openSX70/Documentation/specifications/DC-motor/pictures/SX70_Motor_Griega_3.jpg

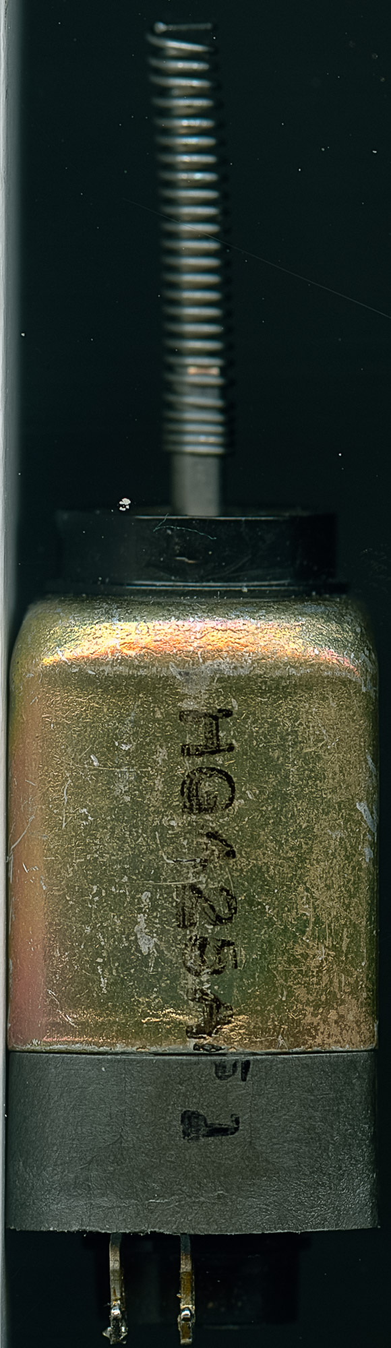
specifications/DC-motor/pictures/SX70_Motor_Griega_3.jpg
