openSX70/Documentation/specifications/DC-motor/pictures/SX70_Motor_Griega_2.jpg

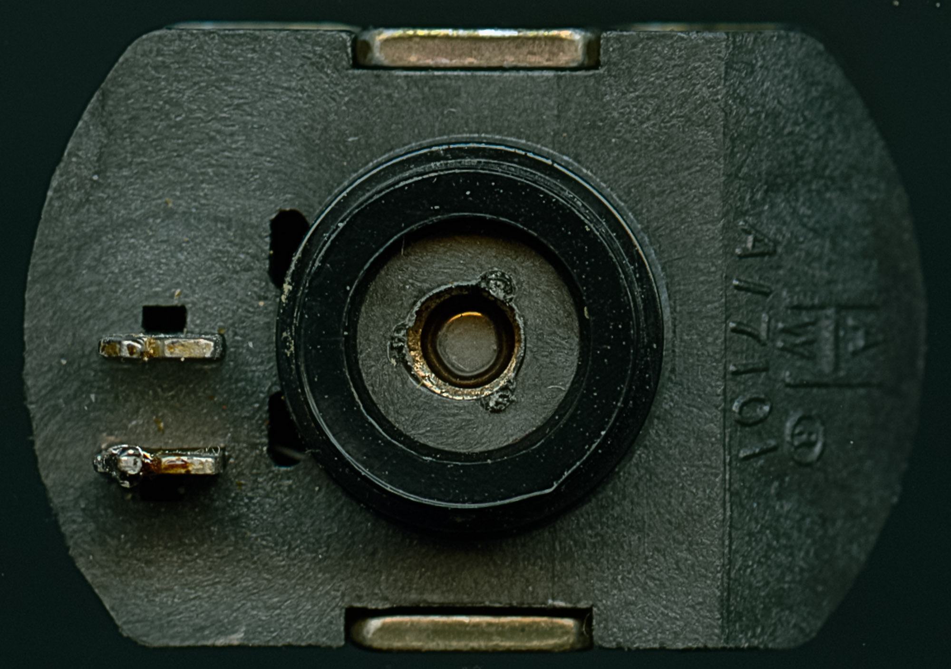
specifications/DC-motor/pictures/SX70_Motor_Griega_2.jpg
