openSX70/Documentation/README.md

# tutorials
All sort of documents and tutorials about the SX70
All sort of documents related to SX70
