openSX70/Documentation/specifications/Basics/SX70-Cable-Routing-GRAND-SCHEME.pdf

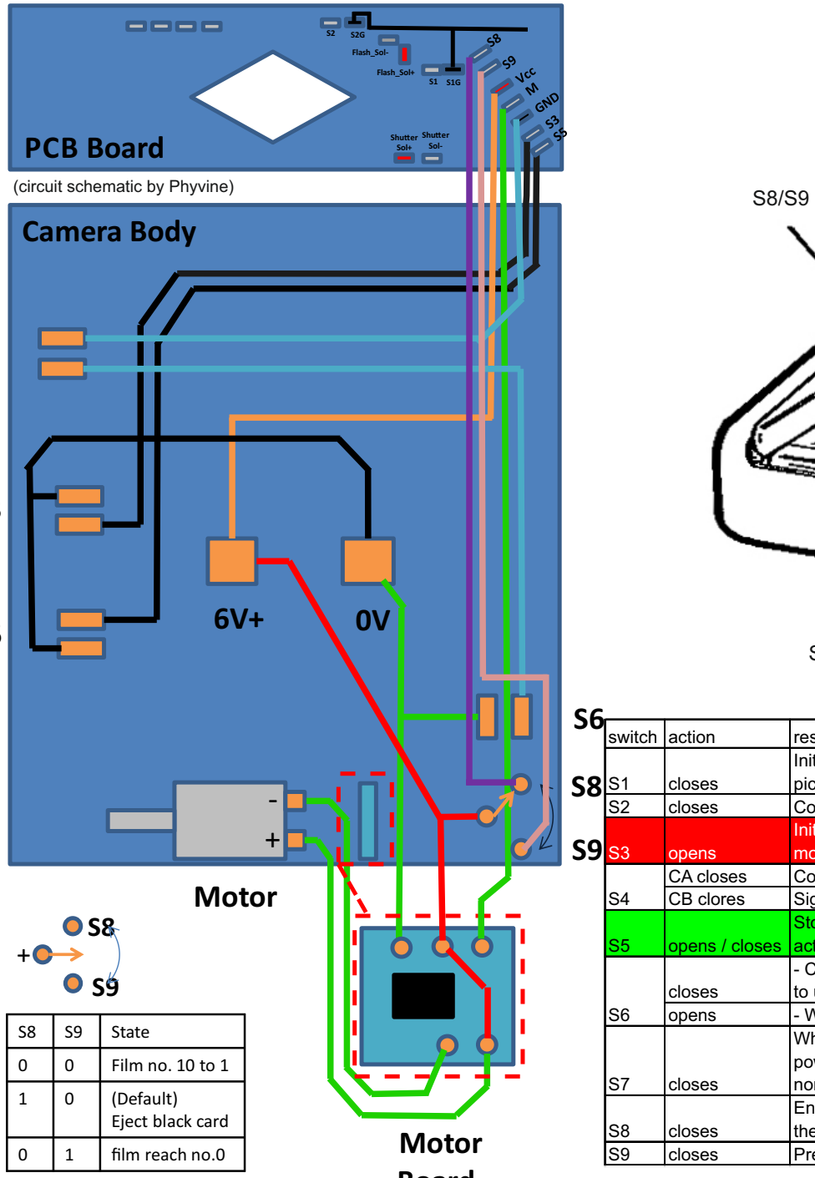
[picture p3: figure]
State; Film no. 10 to 1; (Default) Eject black card; film reach no.0; Motor; PCB Board; Camera Body; Flash_Sol+; Flash_Sol-; Shuer Sol+; Shuer Sol-; (circuit schematic by Phyvine)

S5

S3

# Board

S7

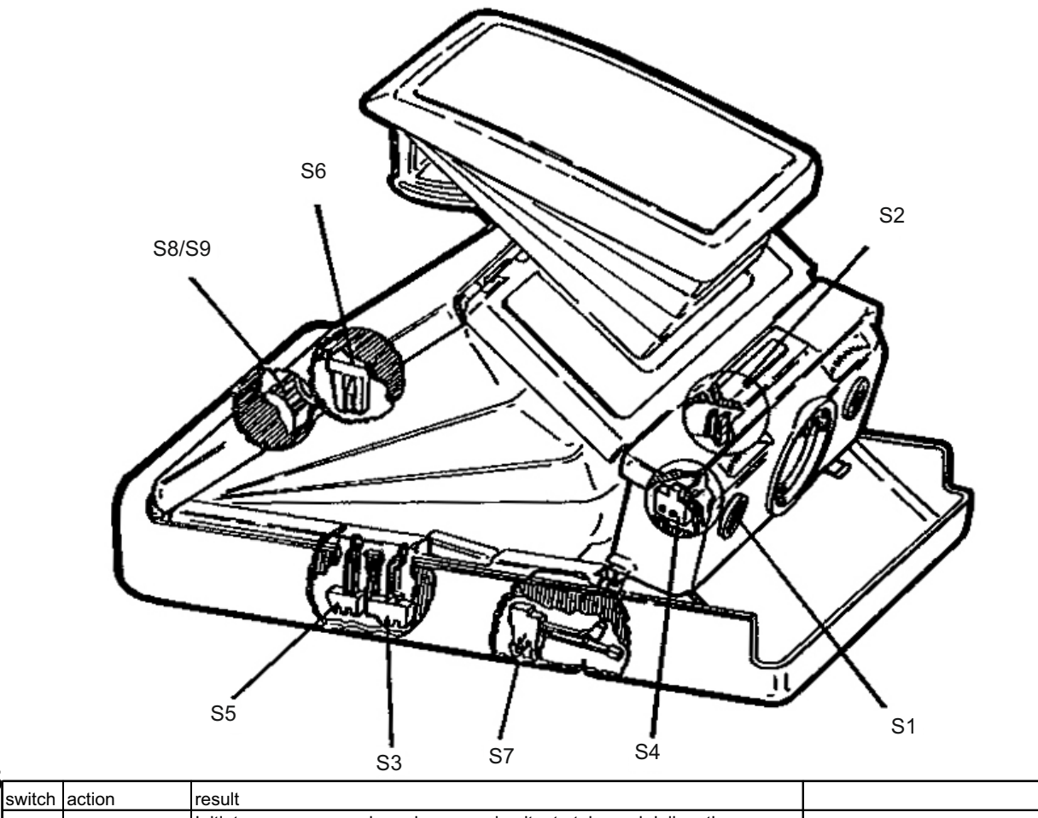
[picture p4: figure]
switch; action; result

S1 | closes | Initiates exposure cycle and causes circuitry to take and deliver the pictures. | Shutter button, taking a picture
S2 | closes | Connects circuitry to take flash pictures. | Flash mode detected
S3 | opens | Initiates «Y», 40 milliseconds delay. (Power down solenoid #2 in the flash mode)
S4 | CA closes | Controls power to solenoid #1 (drop current to holding level)
| CB clores | Signals the ECM to start the motor.
S5 | opens / closes | Stops motor both by closing and opening depeending uponsequence of action and internal circuitry.
S6 | closes | - Connects the battery to the electronic circuitry when thecamera is open to use. | Camera closed-OFF
| opens | - When the camera closed, cuts power from battery. | Camera open-ON
S7 | closes | When S8 is also closed, it provides power to the camera when the front power is latched (for dark slide eject). Also acts as an interlock during normal picture taking.
S8 | closes | Enables (with S7 closed) the circuitry to eject dark slide.Opens again after the dark slide is ejected. | counter-related
S9 | closes | Prevents firing flash if film pack counter is on «0». | counter-related
