openSX70/Documentation/specifications/shutter/SX70_aperture.pdf

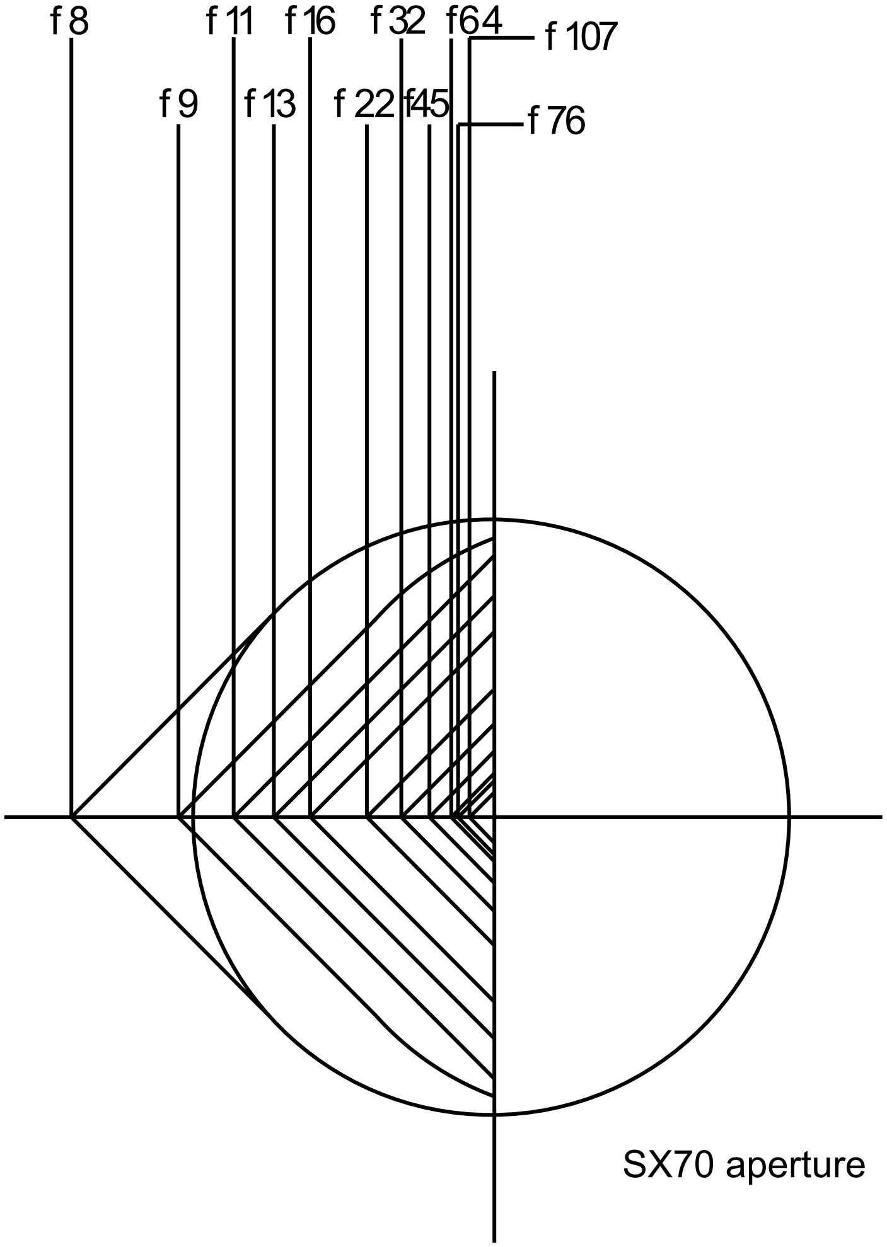
[picture p5: figure]
SX70 aperture
