openSX70/Documentation/lens&bellows-openSX70.png

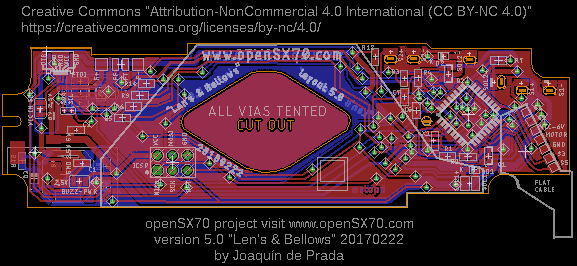
lens&bellows-openSX70.png
