openSX70/Documentation/specifications/DC-motor/FK-1505A-1.jpg

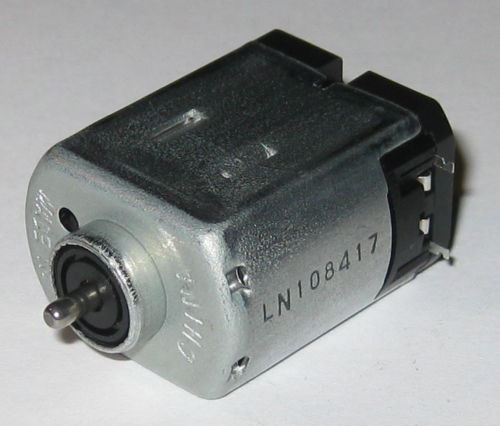
specifications/DC-motor/FK-1505A-1.jpg
