openSX70/Documentation/specifications/flexcable/flexcable-grid-scan.jpg

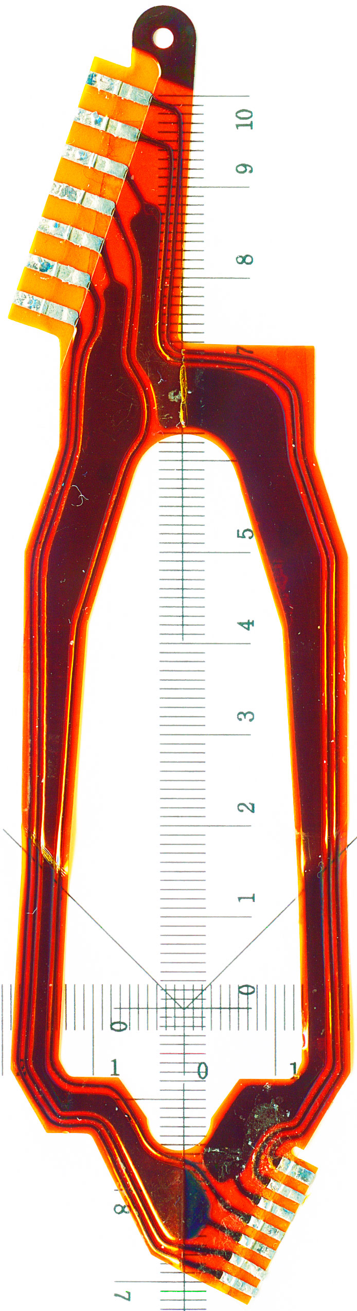
specifications/flexcable/flexcable-grid-scan.jpg
