openSX70/Documentation/specifications/outline/Sonar-LED.jpg

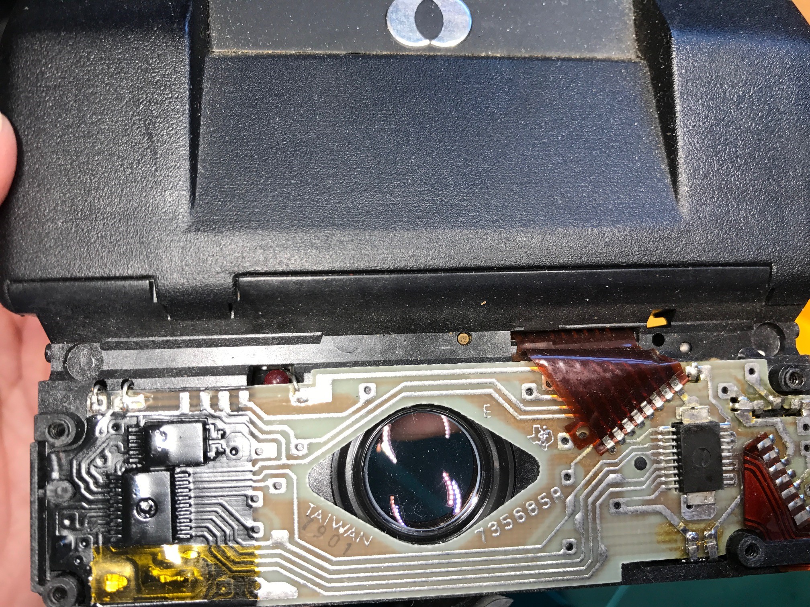
specifications/outline/Sonar-LED.jpg
