openSX70/Documentation/specifications/powerdrop/cablecortoalpha2.png

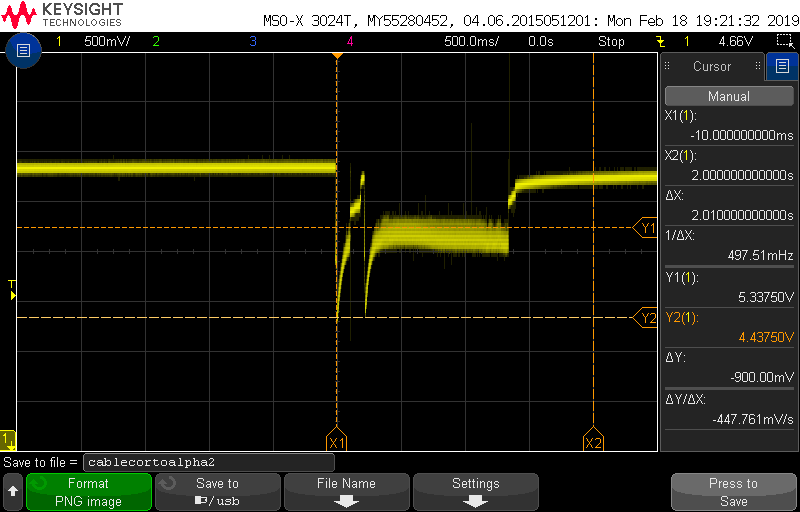
specifications/powerdrop/cablecortoalpha2.png
