openSX70/Documentation/specifications/powerdrop/cablecortoalpha4.png

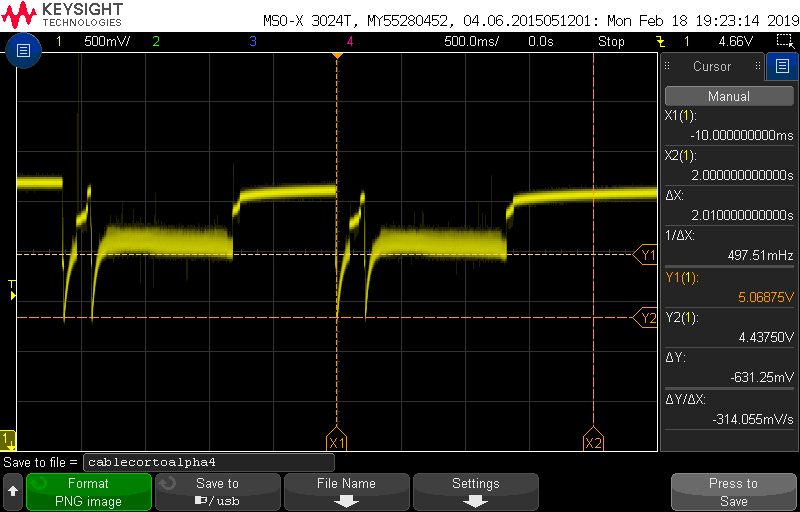
specifications/powerdrop/cablecortoalpha4.png
