openSX70/Documentation/specifications/powerdrop/cablecortoalpha.png

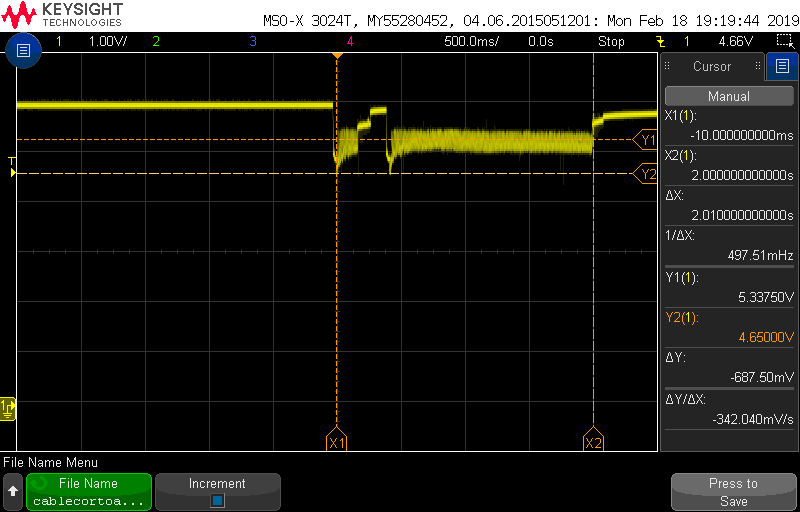
specifications/powerdrop/cablecortoalpha.png
