openSX70/Documentation/specifications/powerdrop/cablecortomodel2 1.bmp

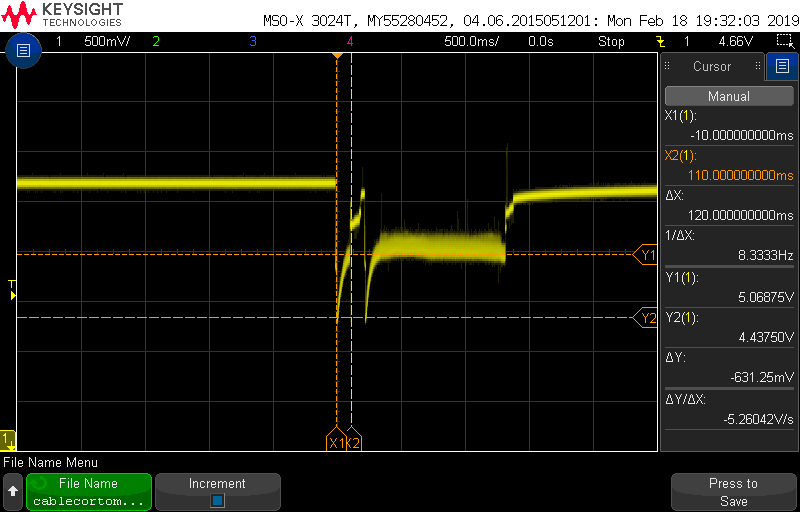
specifications/powerdrop/cablecortomodel2 1.bmp
