openSX70/Documentation/specifications/powerdrop/cablecortomodel2 2.bmp

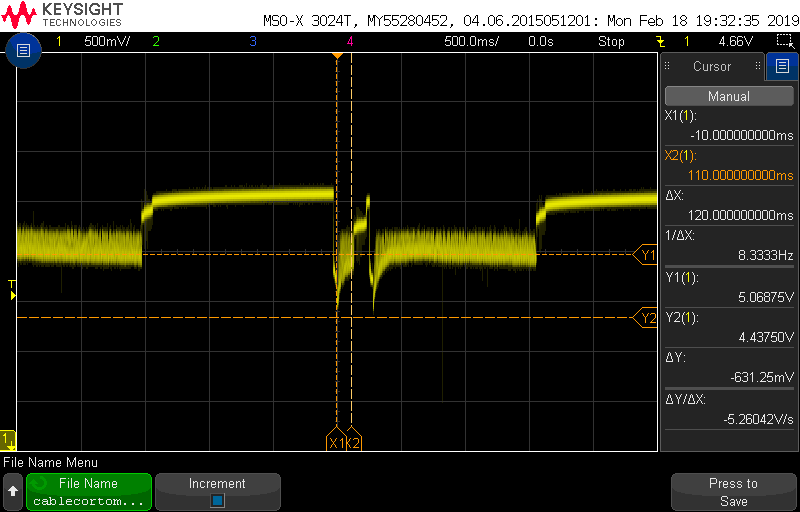
specifications/powerdrop/cablecortomodel2 2.bmp
