openSX70/Documentation/specifications/powerdrop/model2.png

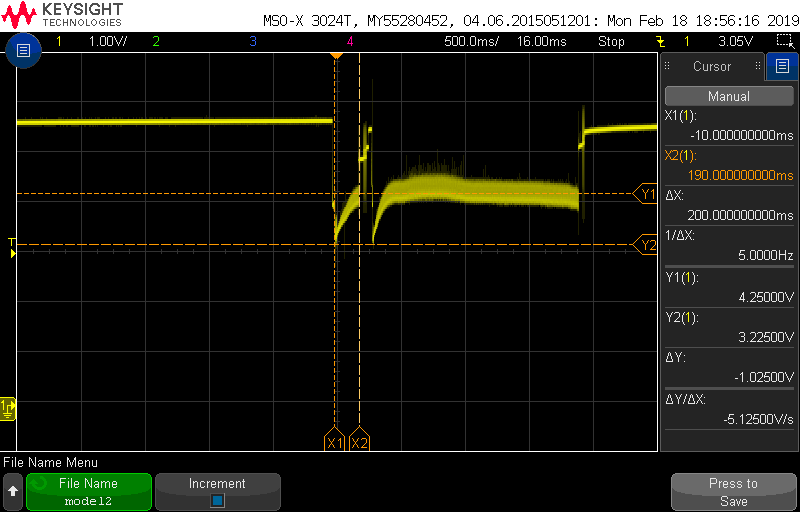
specifications/powerdrop/model2.png
