openSX70/Documentation/specifications/shutter/20181019_SX70_shutter-blades-1HC.jpg

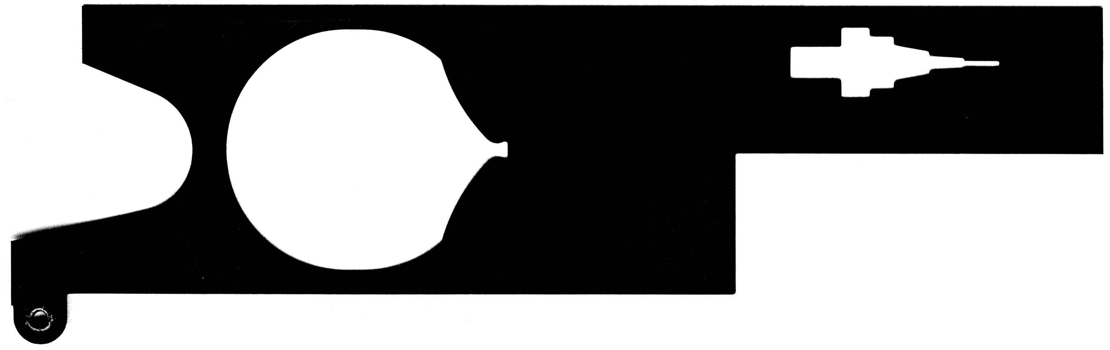
specifications/shutter/20181019_SX70_shutter-blades-1HC.jpg
