openSX70/Documentation/specifications/sonar/2018-12-30-beta-program-12.jpg

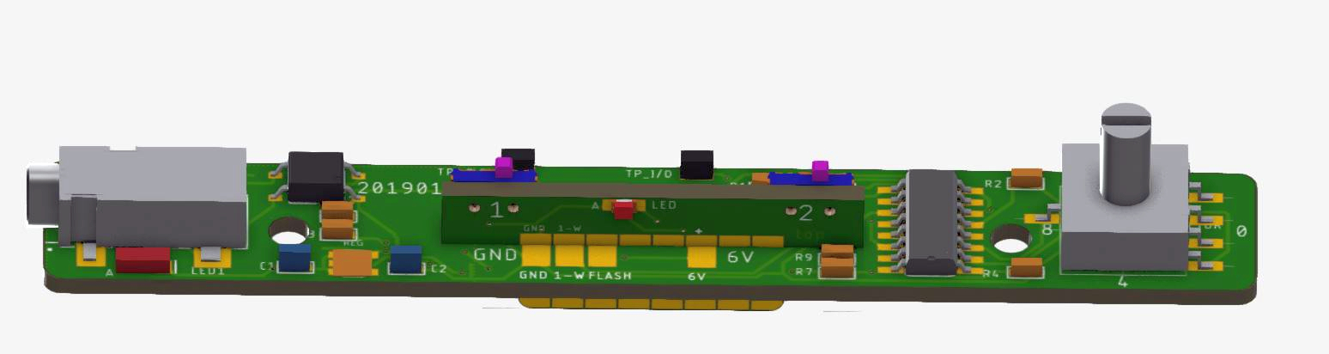
specifications/sonar/2018-12-30-beta-program-12.jpg
