openSX70/Documentation/specifications/sonar/orange-focus-WA000004.BMP

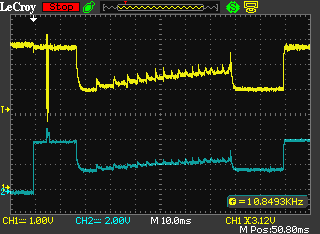
specifications/sonar/orange-focus-WA000004.BMP
