openSX70/Documentation/specifications/sonar/orange-focus-WA000007.BMP

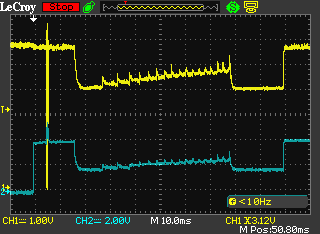
specifications/sonar/orange-focus-WA000007.BMP
