openSX70/Documentation/specifications/sonar/orange-park-WA000010.BMP

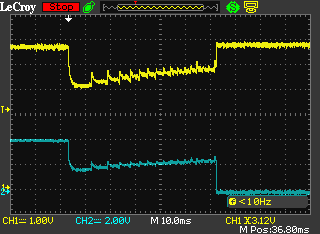
specifications/sonar/orange-park-WA000010.BMP
