openSX70/Documentation/specifications/sonar/PCB_outline-SonarV3_SIMPLE_UPDATE_Colors.jpg

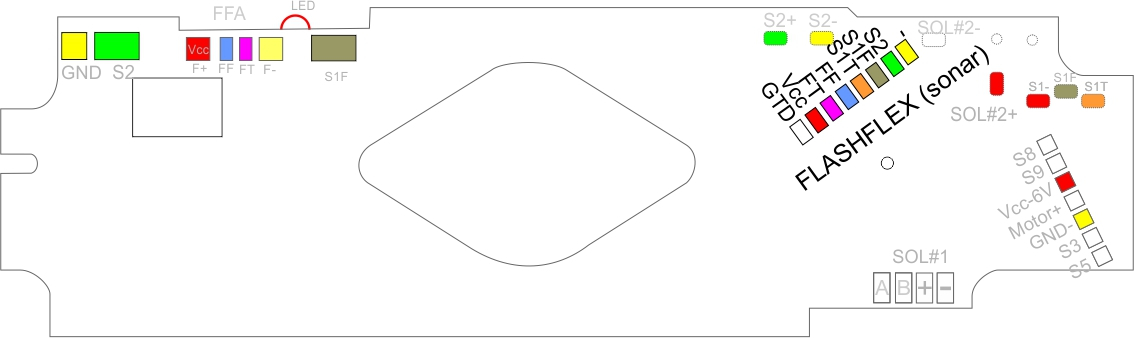
specifications/sonar/PCB_outline-SonarV3_SIMPLE_UPDATE_Colors.jpg
