openSX70/Documentation/specifications/sonar/WA000001.BMP

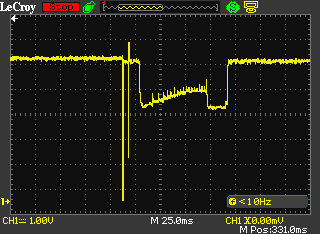
specifications/sonar/WA000001.BMP
