openSX70/Documentation/specifications/sonar/WA000003.BMP

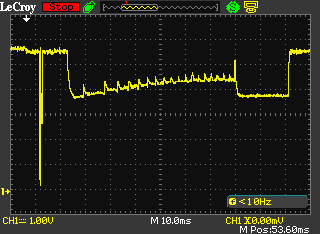
specifications/sonar/WA000003.BMP
