openSX70/Documentation/specifications/sonar/WA000004.BMP

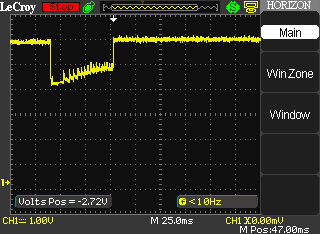
specifications/sonar/WA000004.BMP
