openSX70/Documentation/specifications/sonar/WA000005.BMP

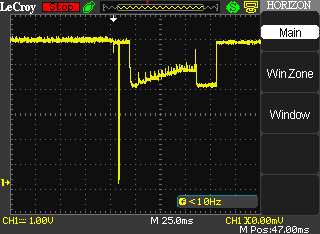
specifications/sonar/WA000005.BMP
