openSX70/Documentation/specifications/sonar/WA000006.BMP

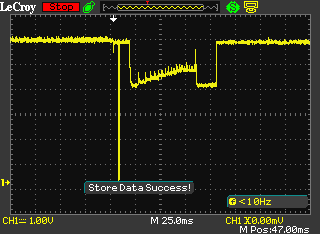
specifications/sonar/WA000006.BMP
