openSX70/Documentation/specifications/sonar/WA000007.BMP

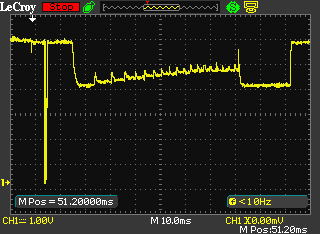
specifications/sonar/WA000007.BMP
