openSX70/Documentation/specifications/sonar/WA000008.BMP

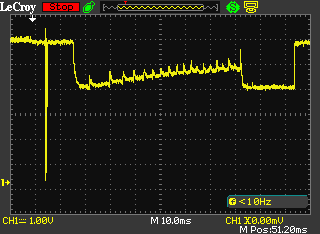
specifications/sonar/WA000008.BMP
