openSX70/Documentation/specifications/sonar/WA000009.BMP

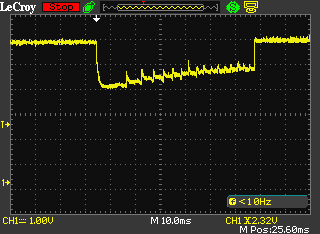
specifications/sonar/WA000009.BMP
