openSX70/Documentation/specifications/sonar/WA000010.BMP

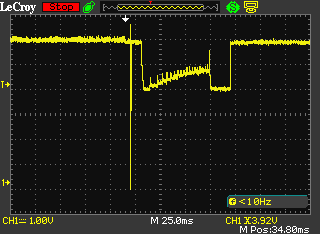
specifications/sonar/WA000010.BMP
