openSX70/Documentation/specifications/sonar/WA000011.BMP

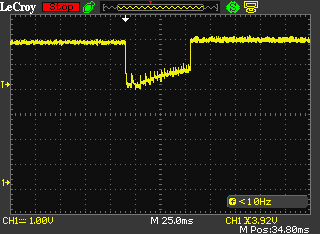
specifications/sonar/WA000011.BMP
