openSX70/Documentation/specifications/sonar/WA000012.BMP

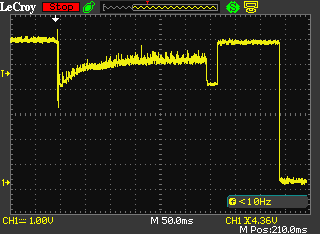
specifications/sonar/WA000012.BMP
