openSX70/Documentation/specifications/sonar/WA000013.BMP

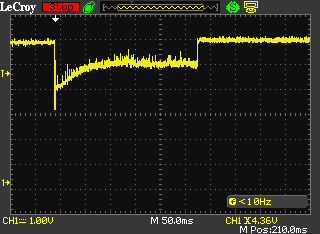
specifications/sonar/WA000013.BMP
