openSX70/Documentation/specifications/sonar/WA000014.BMP

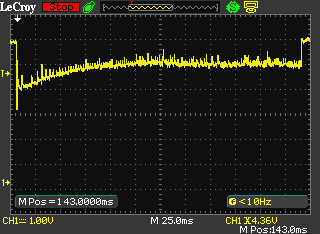
specifications/sonar/WA000014.BMP
