openSX70/Documentation/specifications/sonar/WA000015.BMP

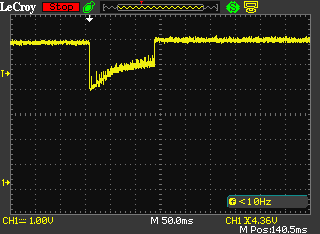
specifications/sonar/WA000015.BMP
