openSX70/Documentation/specifications/sonar/white-focus-WA000002.BMP

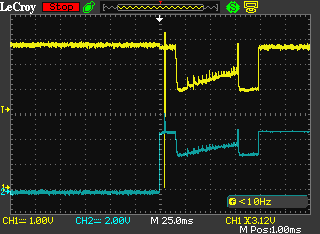
specifications/sonar/white-focus-WA000002.BMP
