openSX70/Documentation/specifications/sonar/white-focus-WA000005.BMP

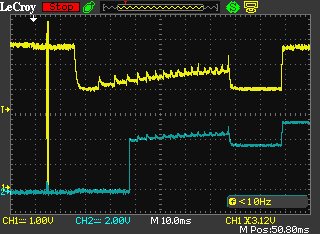
specifications/sonar/white-focus-WA000005.BMP
