openSX70/Documentation/specifications/sonar/white-park-WA000008.BMP

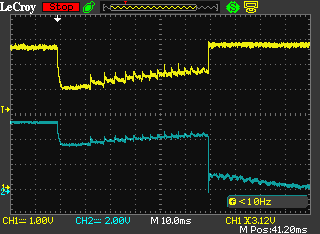
specifications/sonar/white-park-WA000008.BMP
