openSX70/Documentation/specifications/sonar/yellow-focus-WA000003.BMP

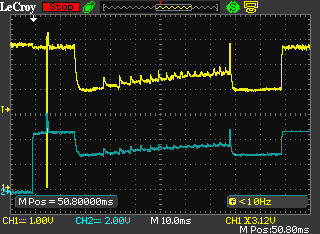
specifications/sonar/yellow-focus-WA000003.BMP
