openSX70/Documentation/specifications/sonar/yellow-focus-WA000006.BMP

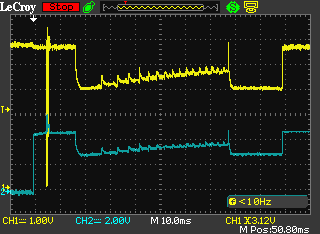
specifications/sonar/yellow-focus-WA000006.BMP
