openSX70/Documentation/specifications/sonar/yellow-park-WA000009.BMP

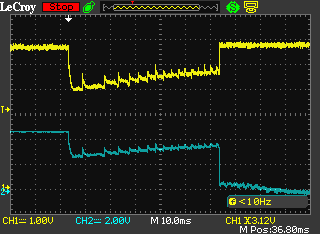
specifications/sonar/yellow-park-WA000009.BMP
