openSX70/Documentation/specifications/flexcable/flex-cable-proper.dxf

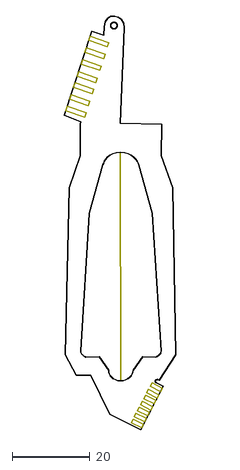
[picture p46: CAD file, 2019-02-09]
specifications/flexcable/flex-cable-proper.dxf
28.8 x 106.8
