openSX70/Documentation/specifications/outline/PCB_outline-SonarV3_NEW_HOLE.dxf

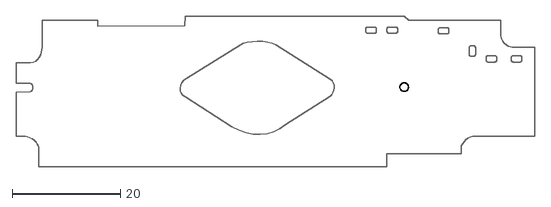
[picture p47: CAD file, 2018-10-12]
specifications/outline/PCB_outline-SonarV3_NEW_HOLE.dxf
95.9 x 27.9
