openSX70/Documentation/specifications/paperPCB/SX-70_Paper_PCB_Model3_BIG2.dxf

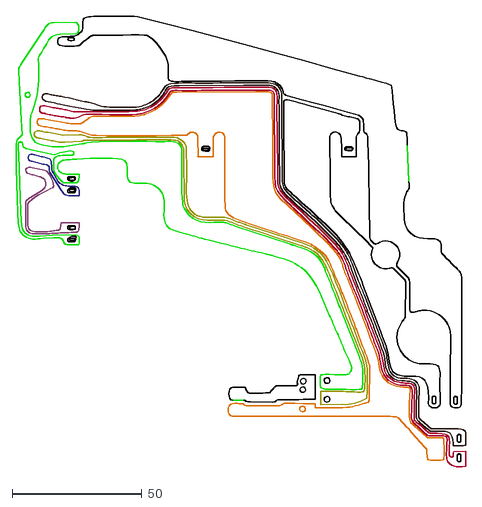
[picture p48: CAD file, 2019-02-09]
specifications/paperPCB/SX-70_Paper_PCB_Model3_BIG2.dxf
173.1 x 173.4
