openSX70/Documentation/specifications/shutter/blade-1.dxf

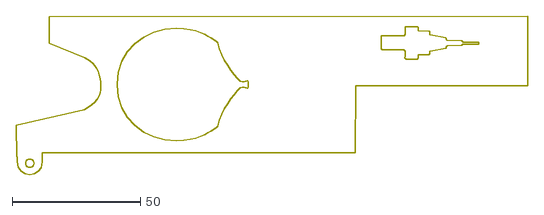
[picture p49: CAD file, 2018-10-22]
specifications/shutter/blade-1.dxf
199.7 x 61.8
