openSX70/Documentation/specifications/flexcable/FLEXCABLE2.dxf

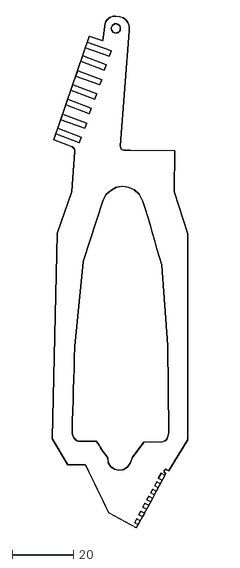
[picture p50: CAD file, 2019-02-09]
specifications/flexcable/FLEXCABLE2.dxf
44.3 x 167.8
