openSX70/Documentation/specifications/outline/PCB_outline-SonarV3_bDOCU_.dxf

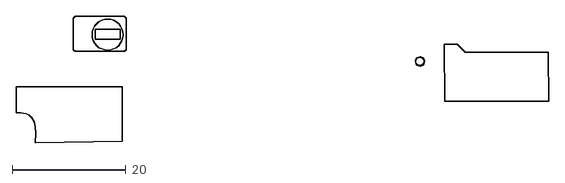
[picture p51: CAD file, 2018-10-12]
specifications/outline/PCB_outline-SonarV3_bDOCU_.dxf
93.6 x 22.2
