openSX70/Documentation/specifications/paperPCB/SX-70_Paper_PCB_Model3_BIG-new.dxf

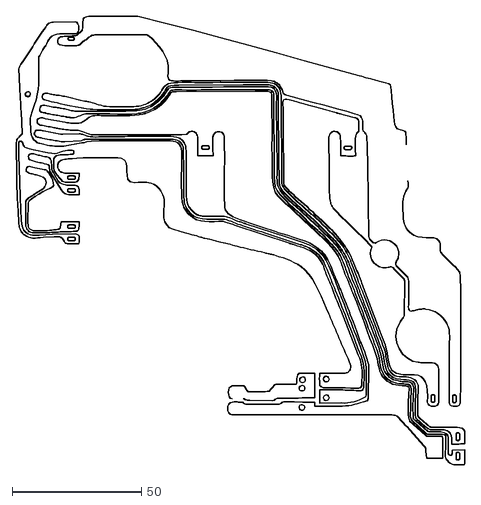
[picture p52: CAD file, 2019-02-09]
specifications/paperPCB/SX-70_Paper_PCB_Model3_BIG-new.dxf
173.1 x 173.4
