openSX70/Documentation/specifications/shutter/blade-2.dxf

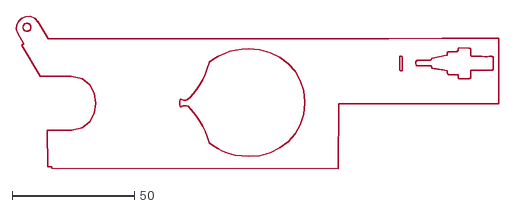
[picture p53: CAD file, 2018-10-22]
specifications/shutter/blade-2.dxf
197.6 x 62.3
