openSX70/Documentation/specifications/outline/PCB_outline-SonarV3_SIMPLE_HOLES2.dxf

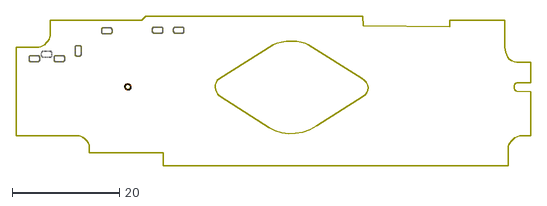
[picture p54: CAD file, 2018-10-12]
specifications/outline/PCB_outline-SonarV3_SIMPLE_HOLES2.dxf
95.9 x 27.9
