openSX70/Documentation/specifications/paperPCB/SX-70_Paper_PCB_Model3_BIG.dxf

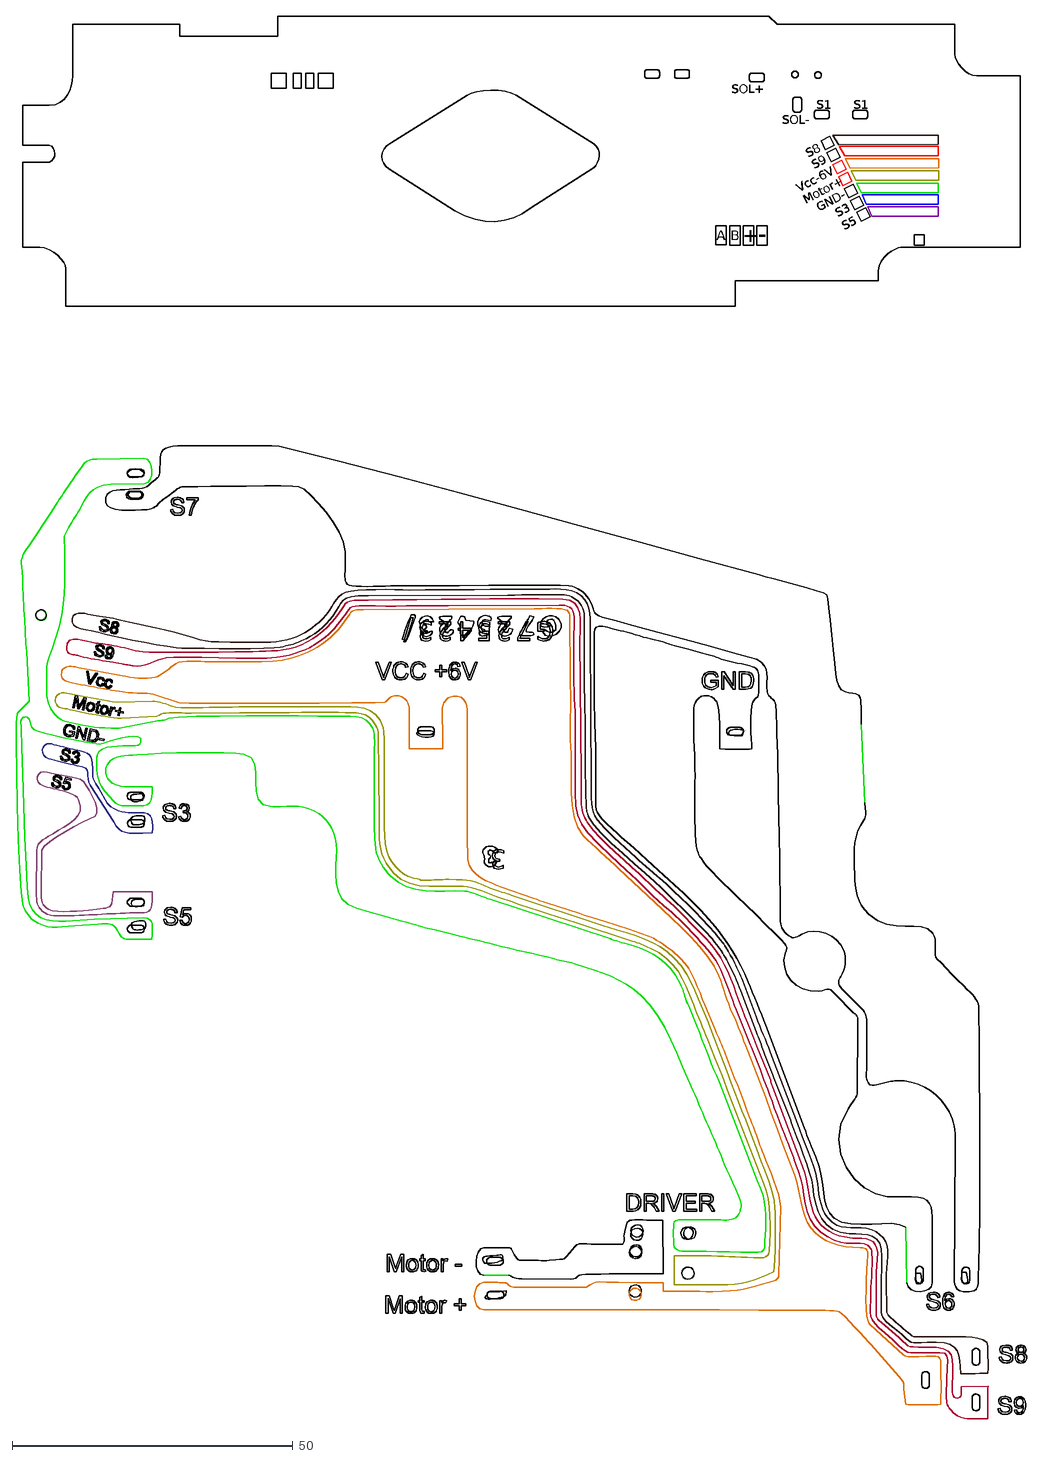
[picture p55: CAD file, 2019-02-09]
specifications/paperPCB/SX-70_Paper_PCB_Model3_BIG.dxf
S1
SOL+
SOL-
A
B
+
-
S8
S3
S9
Vcc-6V
Motor+
GND-
S5
