openSX70/Documentation/specifications/outline/PCB_outline-SonarV3_SIMPLE_dimensions.dxf

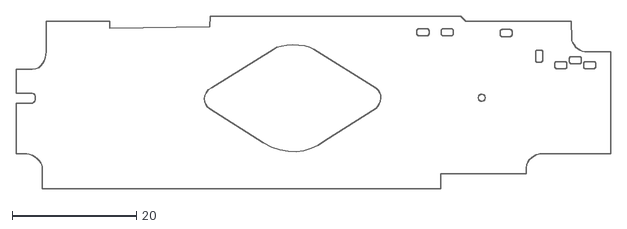
[picture p56: CAD file, 2018-10-12]
specifications/outline/PCB_outline-SonarV3_SIMPLE_dimensions.dxf
95.9 x 27.9
