openSX70/Documentation/specifications/outline/PCB_outline-SonarV2_tDOCU.dxf

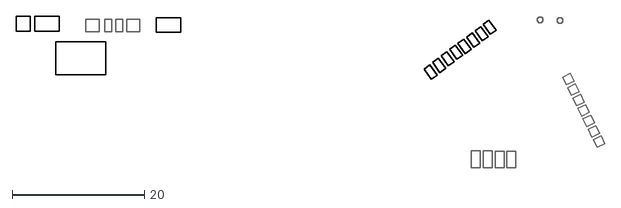
[picture p57: CAD file, 2018-10-12]
specifications/outline/PCB_outline-SonarV2_tDOCU.dxf
89.0 x 22.9
