openSX70/Documentation/specifications/outline/PCB_outline-SonarV3_SIMPLE_UPDATE_Colors_MIRRROR.dxf

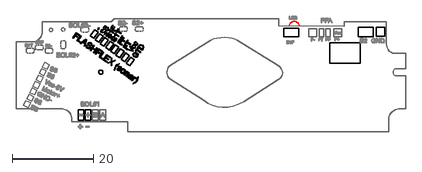
[picture p58: CAD file, 2018-10-12]
specifications/outline/PCB_outline-SonarV3_SIMPLE_UPDATE_Colors_MIRRROR.dxf
95.9 x 28.4
