openSX70/Documentation/specifications/outline/PCB_outline-SonarV3_SIMPLE_texts.dxf

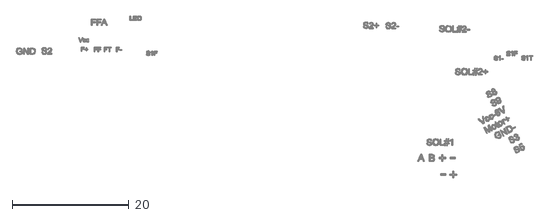
[picture p59: CAD file, 2018-10-12]
specifications/outline/PCB_outline-SonarV3_SIMPLE_texts.dxf
88.5 x 27.8
