openSX70/Documentation/specifications/outline/PCB_outline-SonarV3_SIMPLE_HOLES.dxf

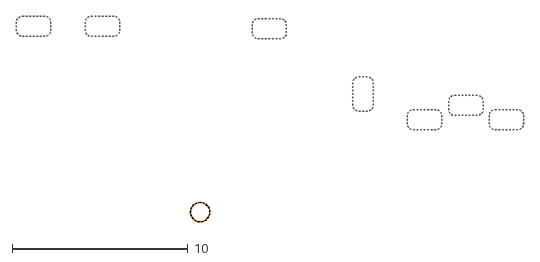
[picture p60: CAD file, 2018-10-12]
specifications/outline/PCB_outline-SonarV3_SIMPLE_HOLES.dxf
28.8 x 11.7
