openSX70/Documentation/specifications/sonar/sonar-wiring.pdf

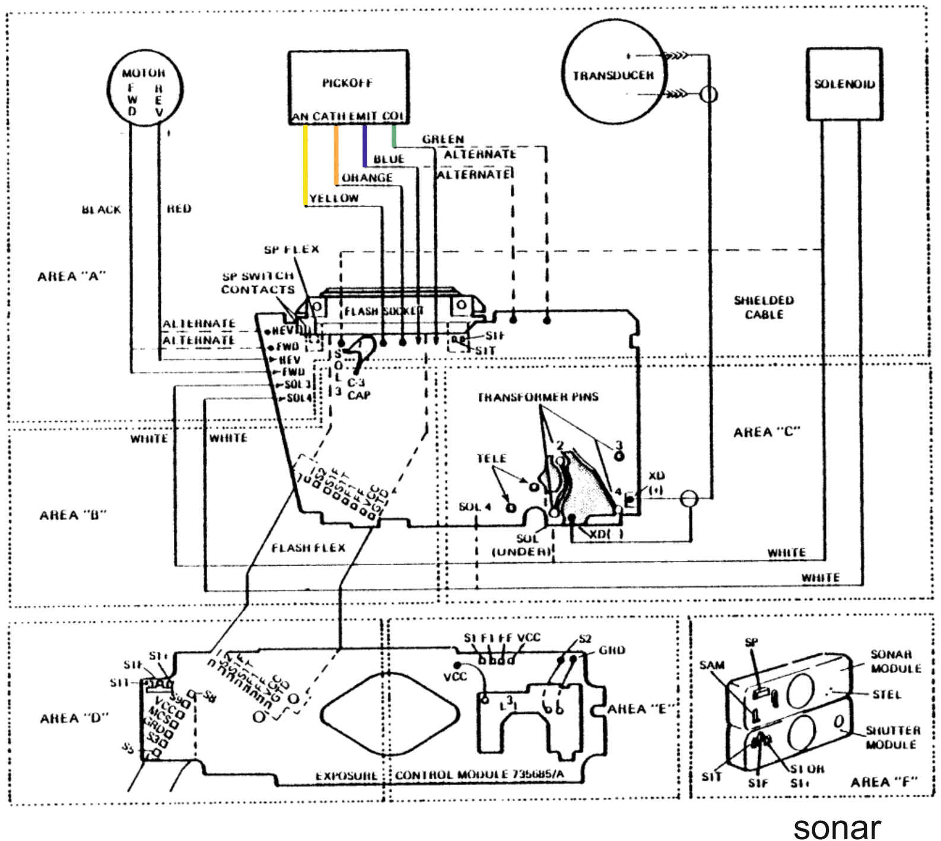
[picture p61: page 1]

sonar
