openSX70/Documentation/specifications/sonar/sonar-wiring-repair-manual.pdf

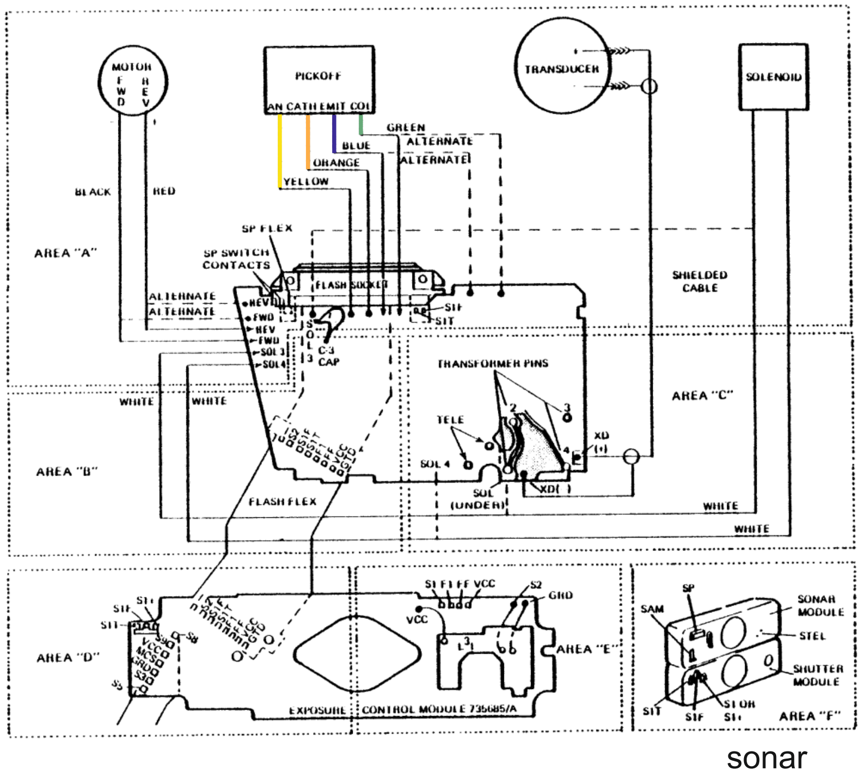
[picture p62: page 1]

sonar
