openSX70/Documentation/specifications/Basics/PCB-SONAR-legend-colours.pdf

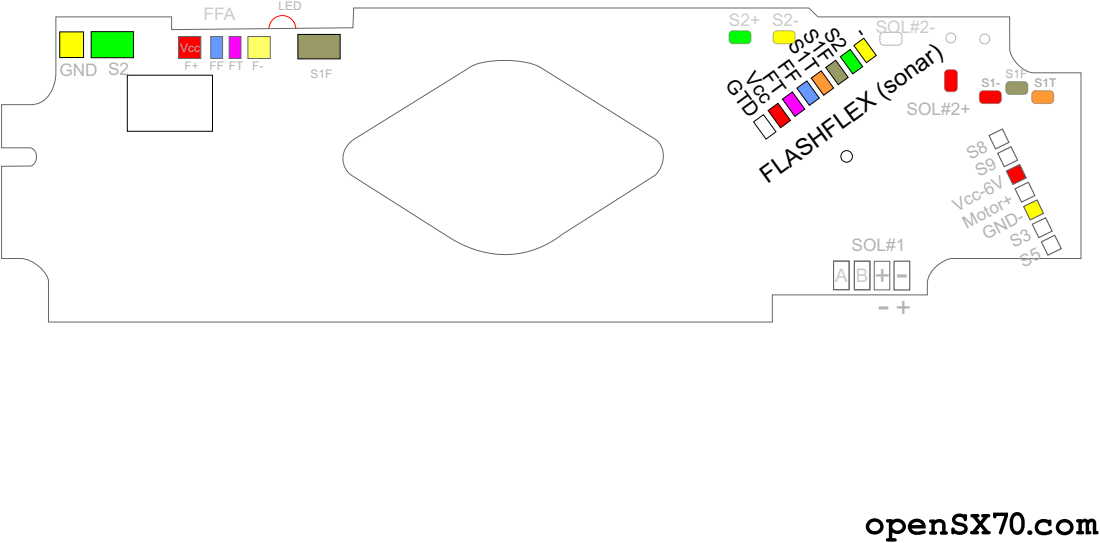
[picture p114: page 1]
SOL#2-; SOL#2+; SOL#1; FFA; GND S2; Vcc; LED

FLASHFLEX (sonar) GTD Vcc FTFF S1T S1FS2-

S9 Vcc-6V Motor+ GND- S5
