openSX70/Documentation/specifications/Basics/PCB_outlines-dimmensions.pdf

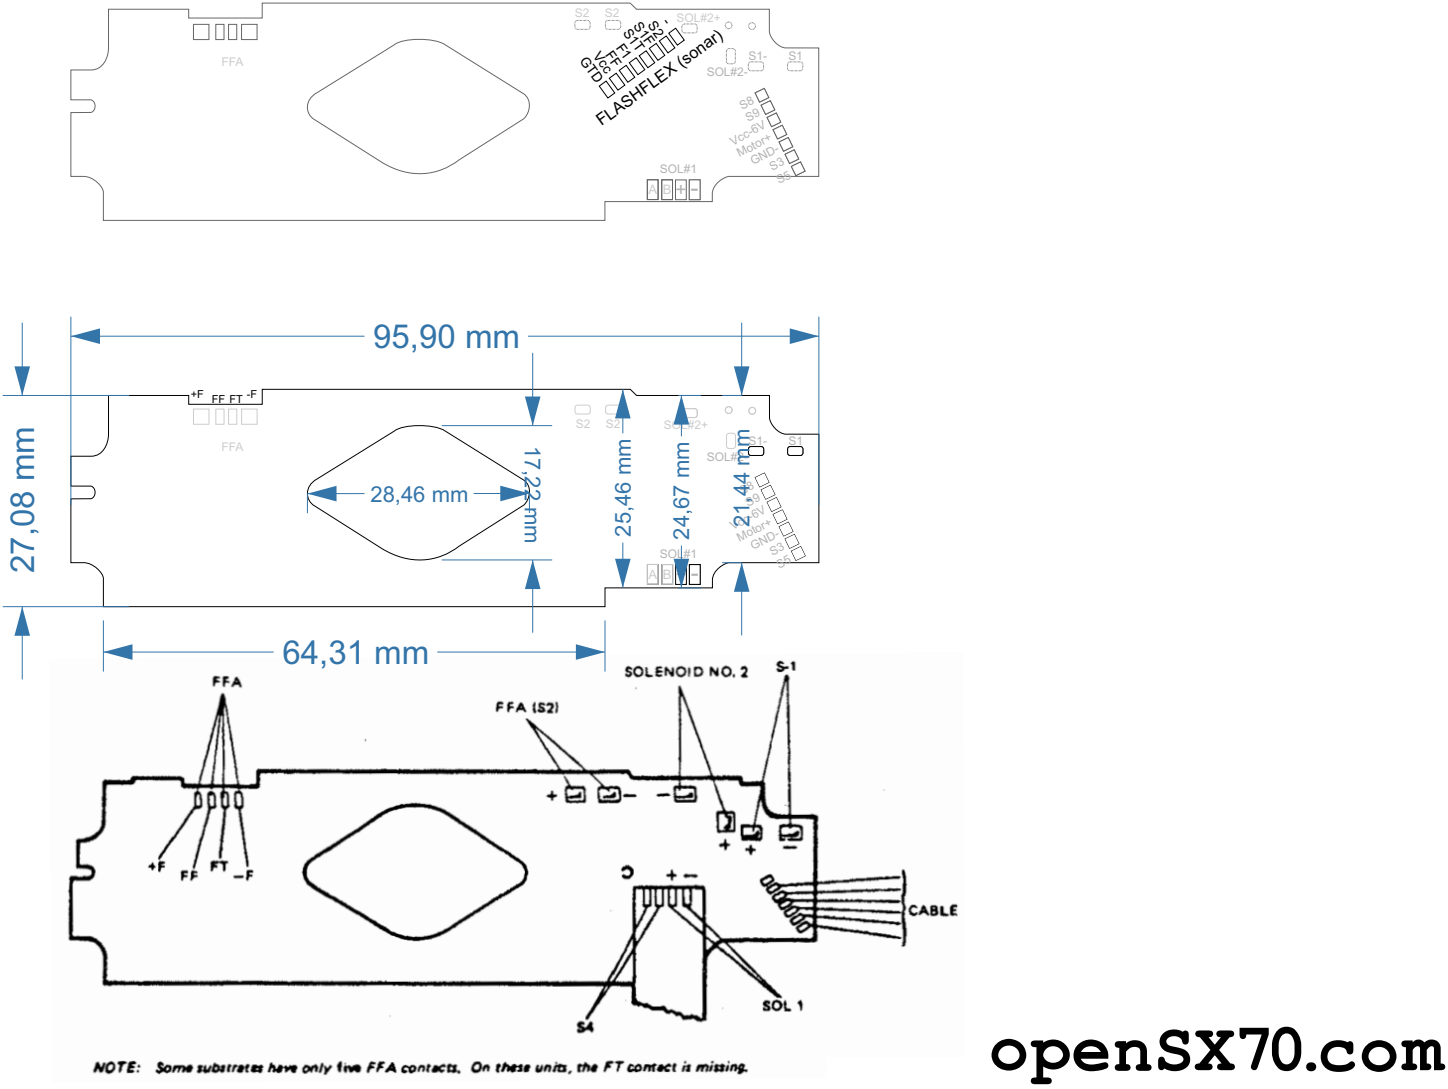
[picture p115: page 1]
SOL#2+; SOL#2-; SOL#1; S9 Vcc-6V Motor+ GND-; S1 FFA; FLASHFLEX (sonar); GTD; Vcc
