openSX70/Documentation/specifications/DC-motor/Motor_SX70_specifications.pdf

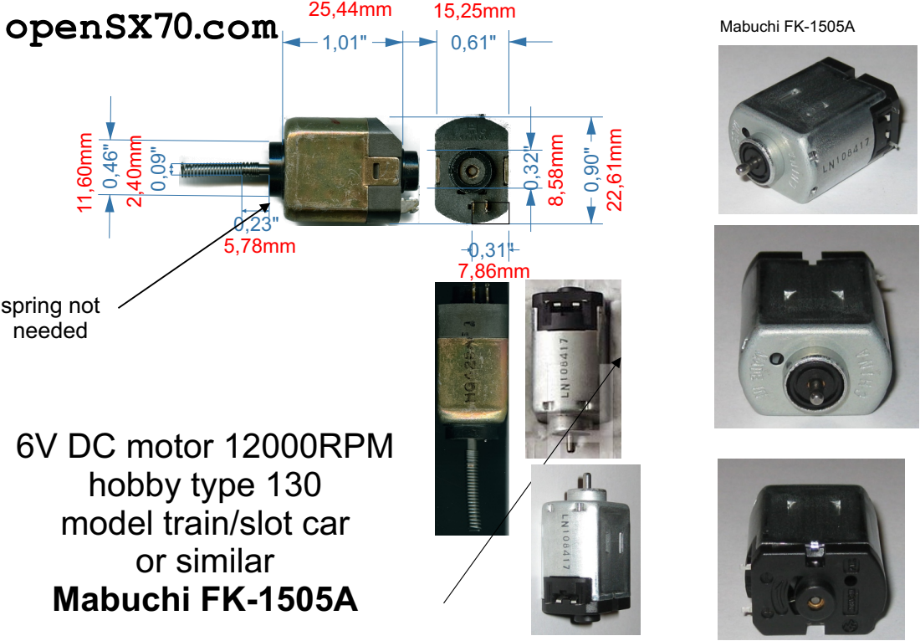
[picture p116: page 1]
spring not needed; Mabuchi FK-1505A

6V DC motor 12000RPM
hobby type 130
model train/slot car
or similar
Mabuchi FK-1505A
