openSX70/Documentation/specifications/connectors/sx70-connector-dimmensions.pdf

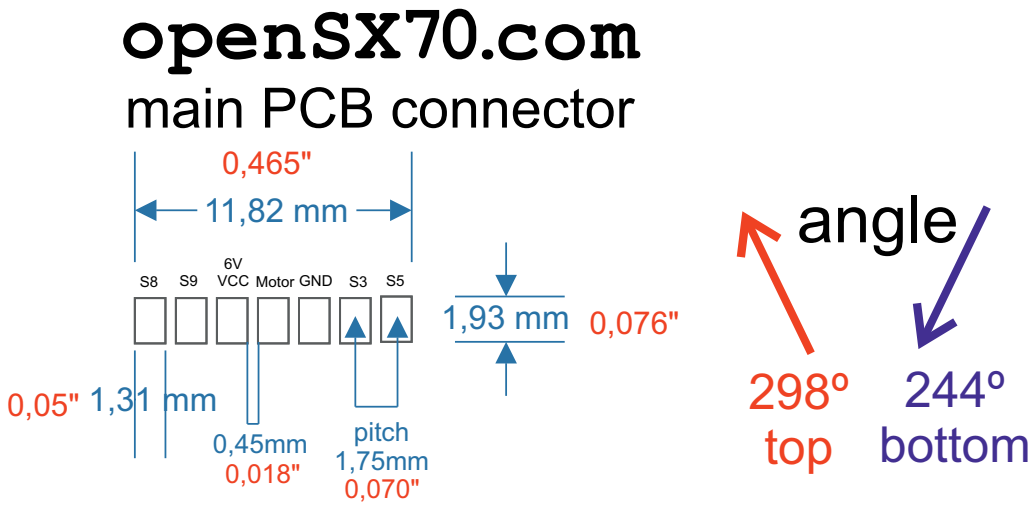
[picture p117: page 1]
298º top; 244º bottom; angle; pitch 1,75mm 0,070"; VCC Motor GND S3
