openSX70/Documentation/specifications/connectors/sx70-SONAR-connector-dimensions.pdf

# ECM to SONAR connector dimensions

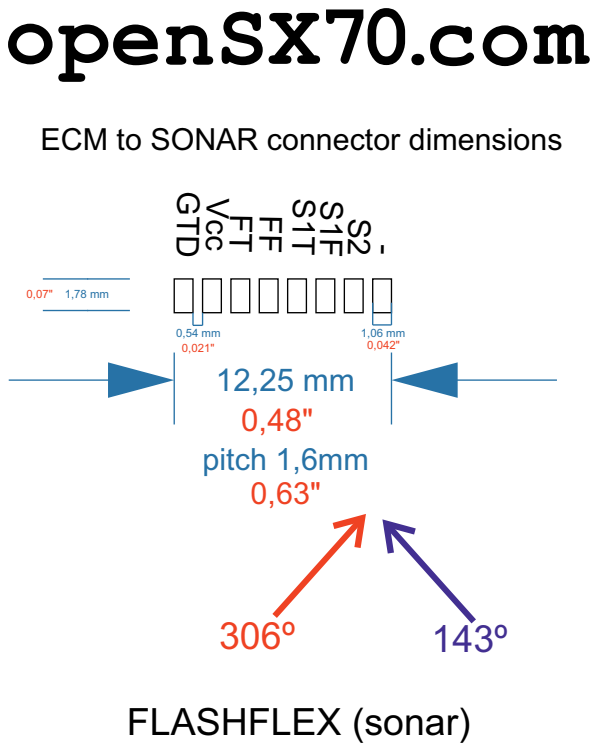
[picture p118: page 1]
FLASHFLEX (sonar); GTD Vcc FT FF; pitch 1,6mm 0,63"
