openSX70/Documentation/custom-labels/openSX70-label-VF.pdf

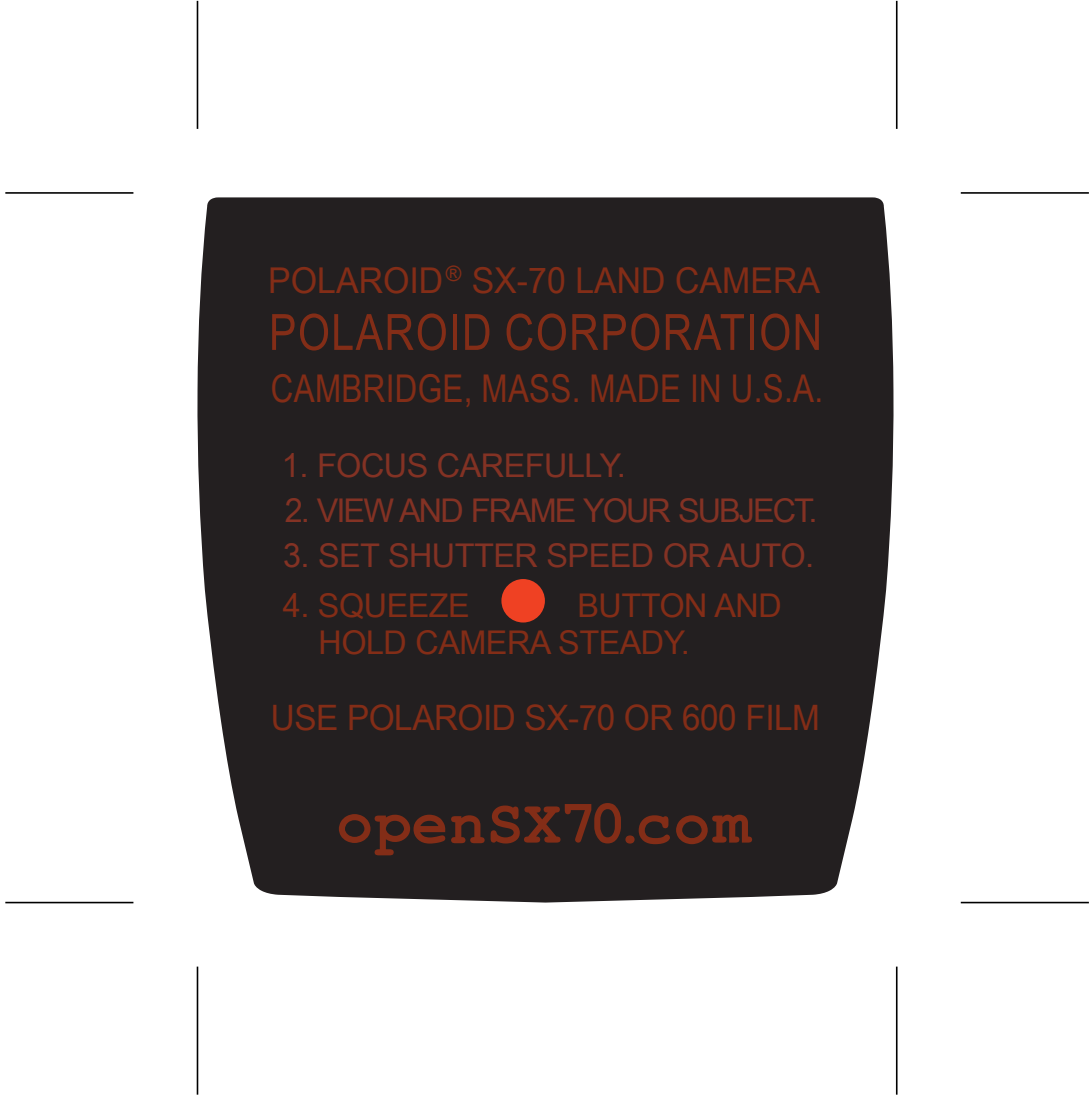
[picture p119: page 1]
4. SQUEEZE; BUTTON AND

POLAROID SX-70 LAND CAMERA ®
POLAROID CORPORATION
CAMBRIDGE, MASS. MADE IN U.S.A.

1. FOCUS CAREFULLY.
2. VIEW AND FRAME YOUR SUBJECT.
3. SET SHUTTER SPEED OR AUTO.
HOLD CAMERA STEADY.

USE POLAROID SX-70 OR 600 FILM
