openSX70/Documentation/openSX70-manuals/openSX70-modular_system20181006.pdf

# Teaching an old camera new tricks:

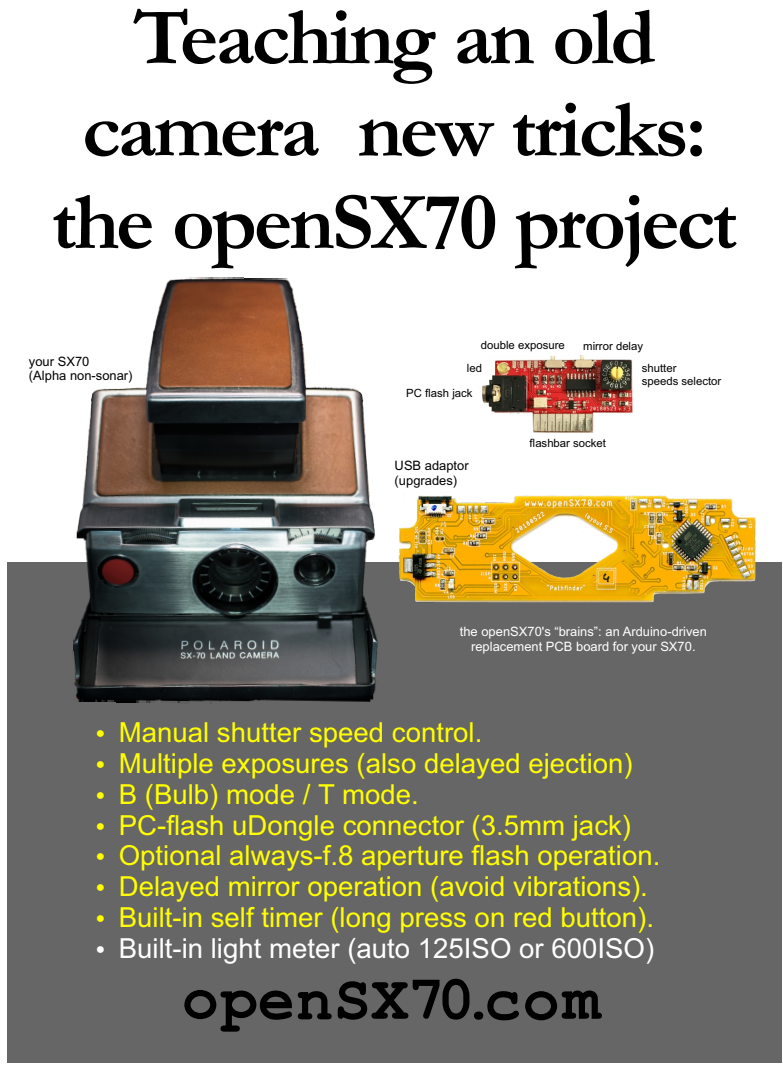
[picture p120: page 1]
the openSX70 project; USB adaptor (upgrades); shutter speeds selector; double exposure; mirror delay; led; flashbar socket

your SX70
(Alpha non-sonar)

PC flash jack

the openSX70's “brains”: an Arduino-driven
replacement PCB board for your SX70.

Manual shutter speed control.
Multiple exposures (also delayed ejection)
B (Bulb) mode / T mode.
PC-flash uDongle connector (3.5mm jack)
Optional always-f.8 aperture flash operation.
Delayed mirror operation (avoid vibrations).
Built-in self timer (long press on red button).
Built-in light meter (auto 125ISO or 600ISO)
