openSX70/Documentation/specifications/Atmega/ATMEGA-328P-LAYOUT.pdf

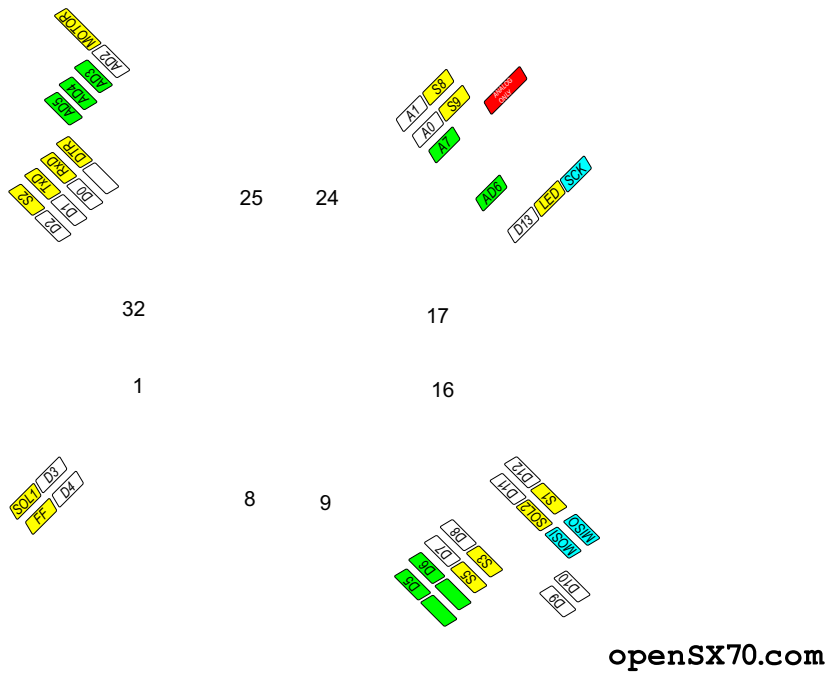
[picture p121: page 1]
