openSX70/Documentation/pedestal-angle-A4.pdf

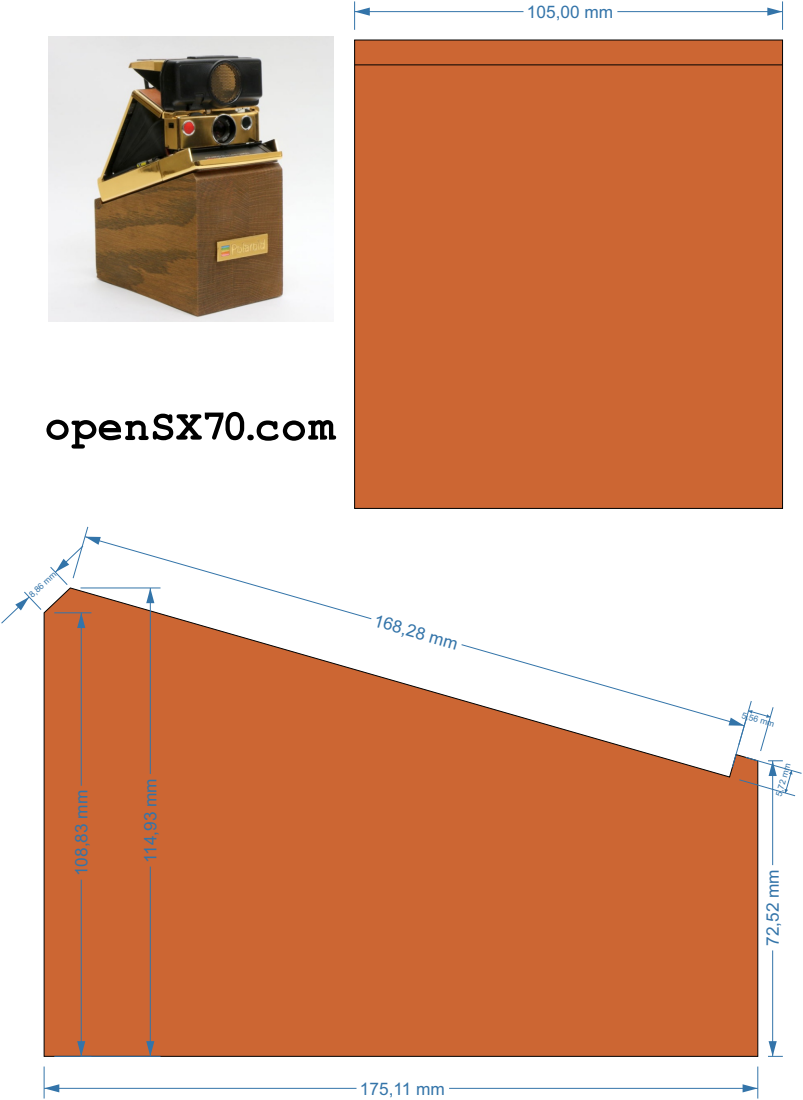
[picture p122: page 1]
