openSX70/Documentation/stand-angle.pdf

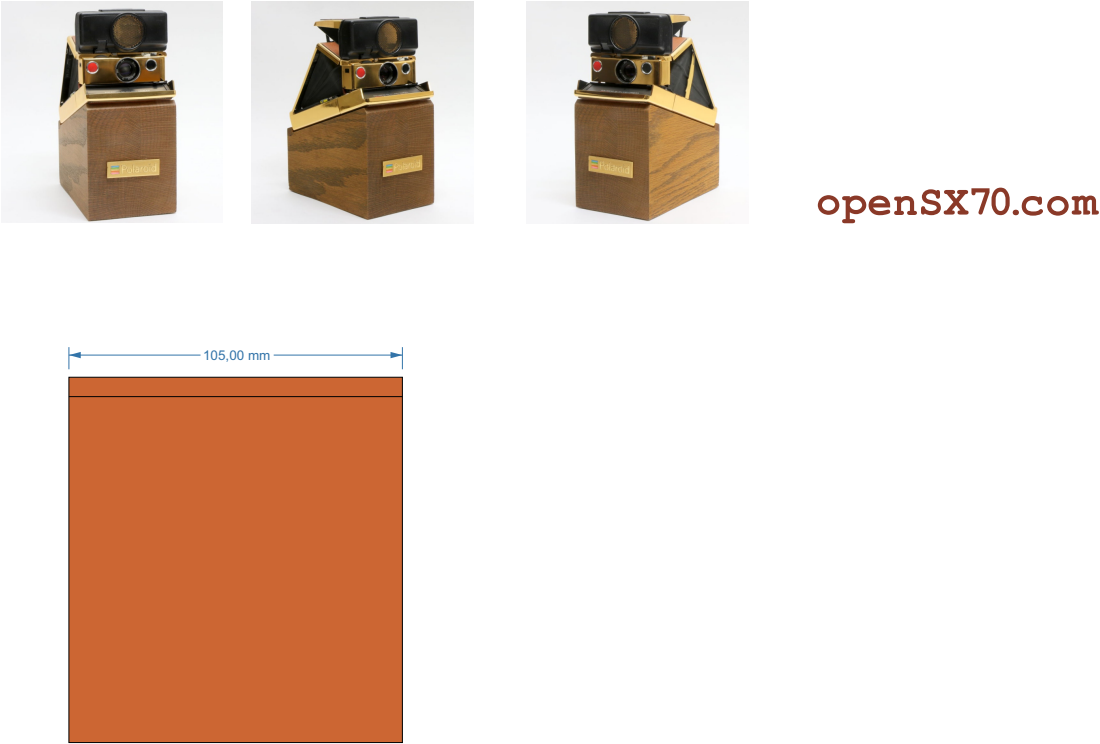
[picture p123: page 1]
