openSX70/Documentation/custom-labels/openSX70-label-VF-vector.pdf

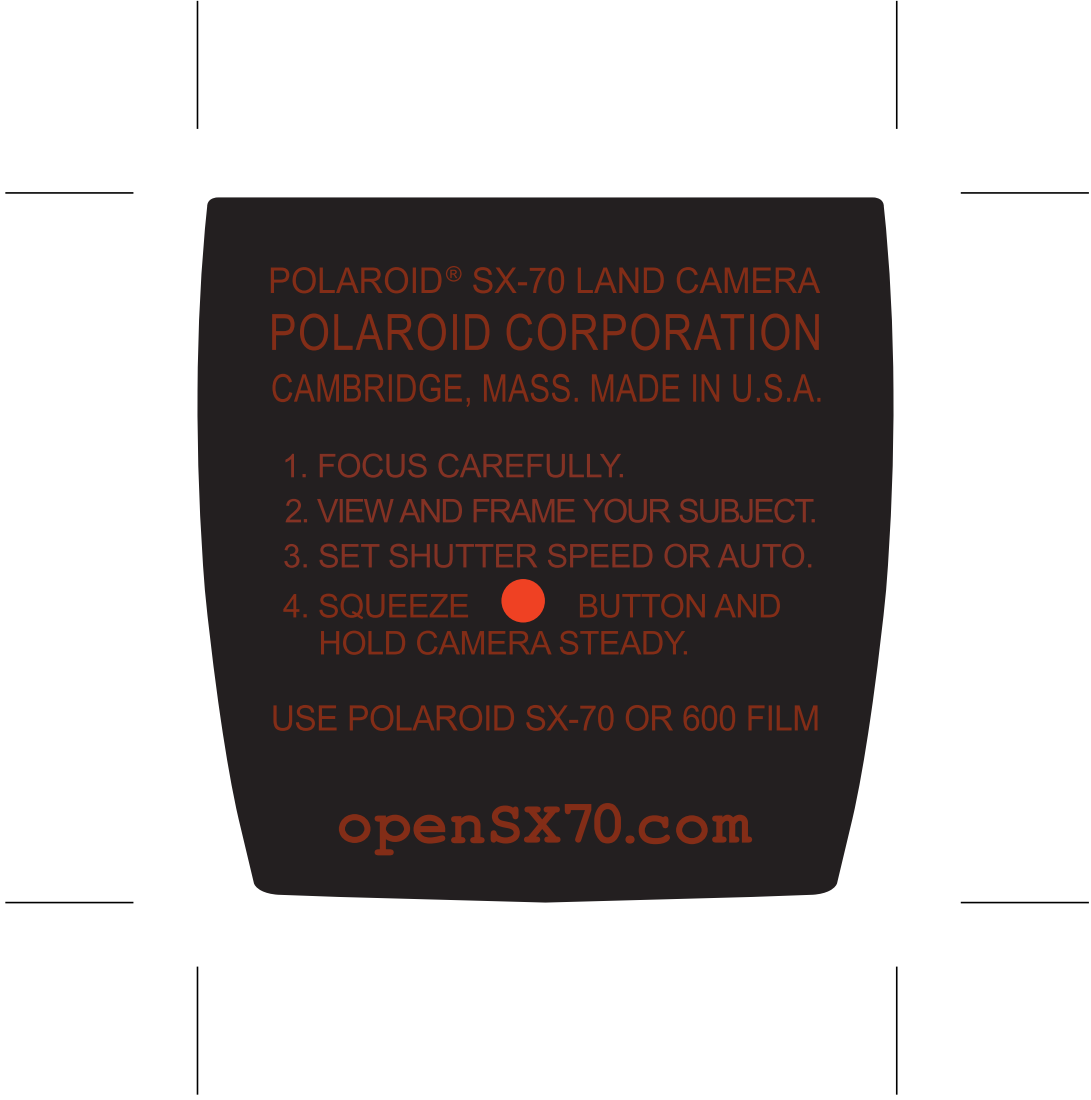
[picture p124: page 1]
