openSX70/Documentation/(commit log)

2017-06-22 Location of capacitors on different SX70s
2017-06-22 Stuff from the internet about capacitor change
2017-06-22 Capacitor mod for SX70 100-600 switch
2018-06-21 added samples
2018-10-12 new files and dimensions
    [PCB_outline-SonarV2_tDOCU.dxf, PCB_outline-SonarV3_NEW_HOLE.dxf, PCB_outline-SonarV3_SIMPLE_HOLES.dxf, PCB_outline-SonarV3_SIMPLE_HOLES2.dxf, PCB_outline-SonarV3_SIMPLE_UPDATE_Colors_MIRRROR.dxf, PCB_outline-SonarV3_SIMPLE_dimensions.dxf, PCB_outline-SonarV3_SIMPLE_texts.dxf, PCB_outline-SonarV3_bDOCU_.dxf]
2018-10-22 added blades DXF and JPG
    [blade-1.dxf, blade-2.dxf]
2018-10-25 Mabuchi motor
2018-11-05 new motor specs
2018-11-05 new folders. stuff from oscilloscope
    [PCB_outline-SonarV2_tDOCU.dxf, PCB_outline-SonarV3_NEW_HOLE.dxf, PCB_outline-SonarV3_SIMPLE_HOLES.dxf, PCB_outline-SonarV3_SIMPLE_HOLES2.dxf, PCB_outline-SonarV3_SIMPLE_UPDATE_Colors_MIRRROR.dxf, PCB_outline-SonarV3_SIMPLE_dimensions.dxf, PCB_outline-SonarV3_SIMPLE_texts.dxf, PCB_outline-SonarV3_bDOCU_.dxf]
2018-11-07 sonar docs
2019-01-07 new gerbers and 3D models
    [20190105_ORIGAMI_V1-H-P.GBL, 20190105_ORIGAMI_V1-H-P.GBO, 20190105_ORIGAMI_V1-H-P.GBP, 20190105_ORIGAMI_V1-H-P.GBS, 20190105_ORIGAMI_V1-H-P.GTL, 20190105_ORIGAMI_V1-H-P.GTO, 20190105_ORIGAMI_V1-H-P.GTP, 20190105_ORIGAMI_V1-H-P.GTS]
2019-02-09 new docs
    [FLEXCABLE2.dxf, SX-70_Paper_PCB_Model3_BIG-new.dxf, SX-70_Paper_PCB_Model3_BIG.dxf, SX-70_Paper_PCB_Model3_BIG2.dxf, flex-cable-proper.dxf]
2019-02-20 power drain scope
    [cablecortoalpha1.csv, cablecortoalpha3.csv, cablecortoalpha5.csv, cablecortomodel2 4.csv, model3.csv]
